xcvista/AT91SAM9260-SBC/ARM926SBC.sch

## EAGLE design ARM926SBC.sch (2017-03-12)

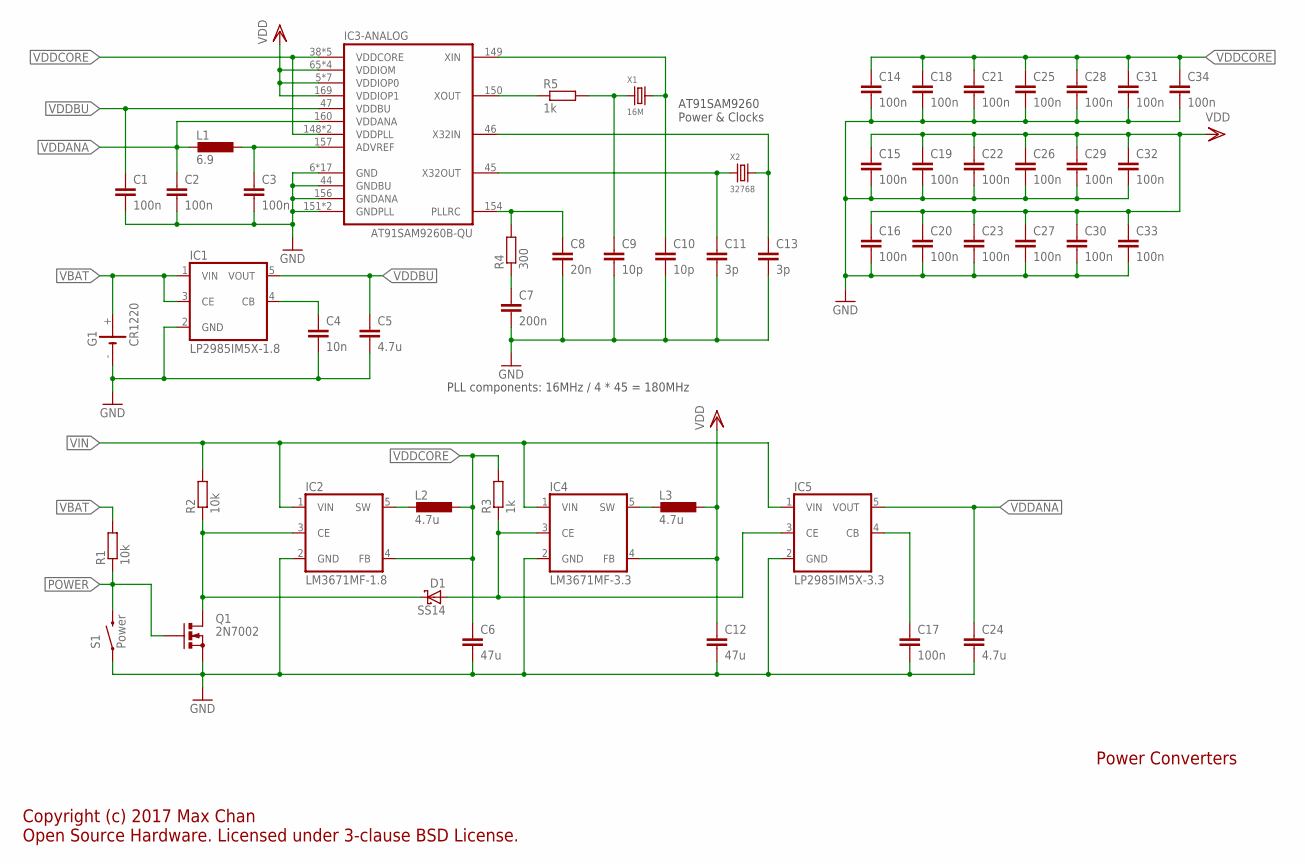
[picture p1: schematic ARM926SBC.sch, sheet 1]

Parts:
C1, C2, C3, C14, C15, C16, C17, C18, C19, C20, C21, C22, C23, C25, C26, C27, C28, C29, C30, C31, C32, C33, C34: 100n; C0603
C4: 10n; C0603
C5, C24: 4.7u; C0603
C6, C12: 47u; C1206
C7: 200n; C0603
C8: 20n; C0603
C9, C10: 10p; C0603
C11, C13: 3p; C0603
D1: SS14; DO214AC
G1: CR1220; CH291-1220LF
IC1: LP2985IM5X-1.8; SOT23-5L
IC2: LM3671MF-1.8; SOT23-5L
IC3: AT91SAM9260B-QU; PQFP208
IC4: LM3671MF-3.3; SOT23-5L
IC5: LP2985IM5X-3.3; SOT23-5L
L1: 6.9; R0603
L2, L3: 4.7u; L5650M
Q1: 2N7002; SOT23
R1, R2: 10k; R0603
R3, R5: 1k; R0603
R4: 300; R0603
S1: Power; TACTILE-SWITCH-1101NE
X1: 16M; CRYSTAL-3225
X2: 32768; CRYSTAL-3215

Connections:
ADVREF: C3.1, IC3.157 (ADVREF), L1.1
GND: C1.2, C2.2, C3.2, C4.2, C5.2, C6.2, C7.2, C8.2, C9.2, C10.2, C11.2, C12.2, C13.2, C14.2, C15.2, C16.2, C17.2, C18.2, C19.2, C20.2, C21.2, C22.2, C23.2, C24.2, C25.2, C26.2, C27.2, C28.2, C29.2, C30.2, C31.2, C32.2, C33.2, C34.2, G1.-, IC1.2 (GND), IC2.2 (GND), IC3.6 (GND), IC3.44 (GNDBU), IC3.151 (GNDPLL), IC3.156 (GNDANA), IC4.2 (GND), IC5.2 (GND), Q1.2 (S), S1.1
unnamed: C8.1, IC3.154 (PLLRC), R4.2
unnamed: C7.1, R4.1
unnamed: IC3.150 (XOUT), R5.1
unnamed: C9.1, R5.2, X1.1
unnamed: C10.1, IC3.149 (XIN), X1.3 (2)
unnamed: C11.1, IC3.45 (X32OUT), X2.1
unnamed: C13.1, IC3.46 (X32IN), X2.2
unnamed: C4.1, IC1.4 (CB)
unnamed: D1.A, IC4.3 (CE), IC5.3 (CE), R3.1
unnamed: IC2.5 (SW), L2.2
unnamed: IC4.5 (SW), L3.2
unnamed: C17.1, IC5.4 (CB)
unnamed: D1.C, IC2.3 (CE), Q1.3 (D), R2.1
POWER: Q1.1 (G), R1.1, S1.2
VBAT: G1.+, IC1.1 (VIN), IC1.3 (CE), R1.2
VDD: C12.1, C15.1, C16.1, C19.1, C20.1, C22.1, C23.1, C26.1, C27.1, C29.1, C30.1, C32.1, C33.1, IC3.5 (VDDIOP0), IC3.65 (VDDIOM), IC3.169 (VDDIOP1), IC4.4 (FB), L3.1
VDDANA: C2.1, C24.1, IC3.160 (VDDANA), IC5.5 (VOUT), L1.2
VDDBU: C1.1, C5.1, IC1.5 (VOUT), IC3.47 (VDDBU)
VDDCORE: C6.1, C14.1, C18.1, C21.1, C25.1, C28.1, C31.1, C34.1, IC2.4 (FB), IC3.38 (VDDCORE), IC3.148 (VDDPLL), L2.1, R3.2
VIN: IC2.1 (VIN), IC4.1 (VIN), IC5.1 (VIN), R2.2

Notes on the sheet:
AT91SAM9260 Power & Clocks
PLL components: 16MHz / 4 * 45 = 180MHz
Power Converters
Copyright (c) 2017 Max Chan Open Source Hardware. Licensed under 3-clause BSD License.

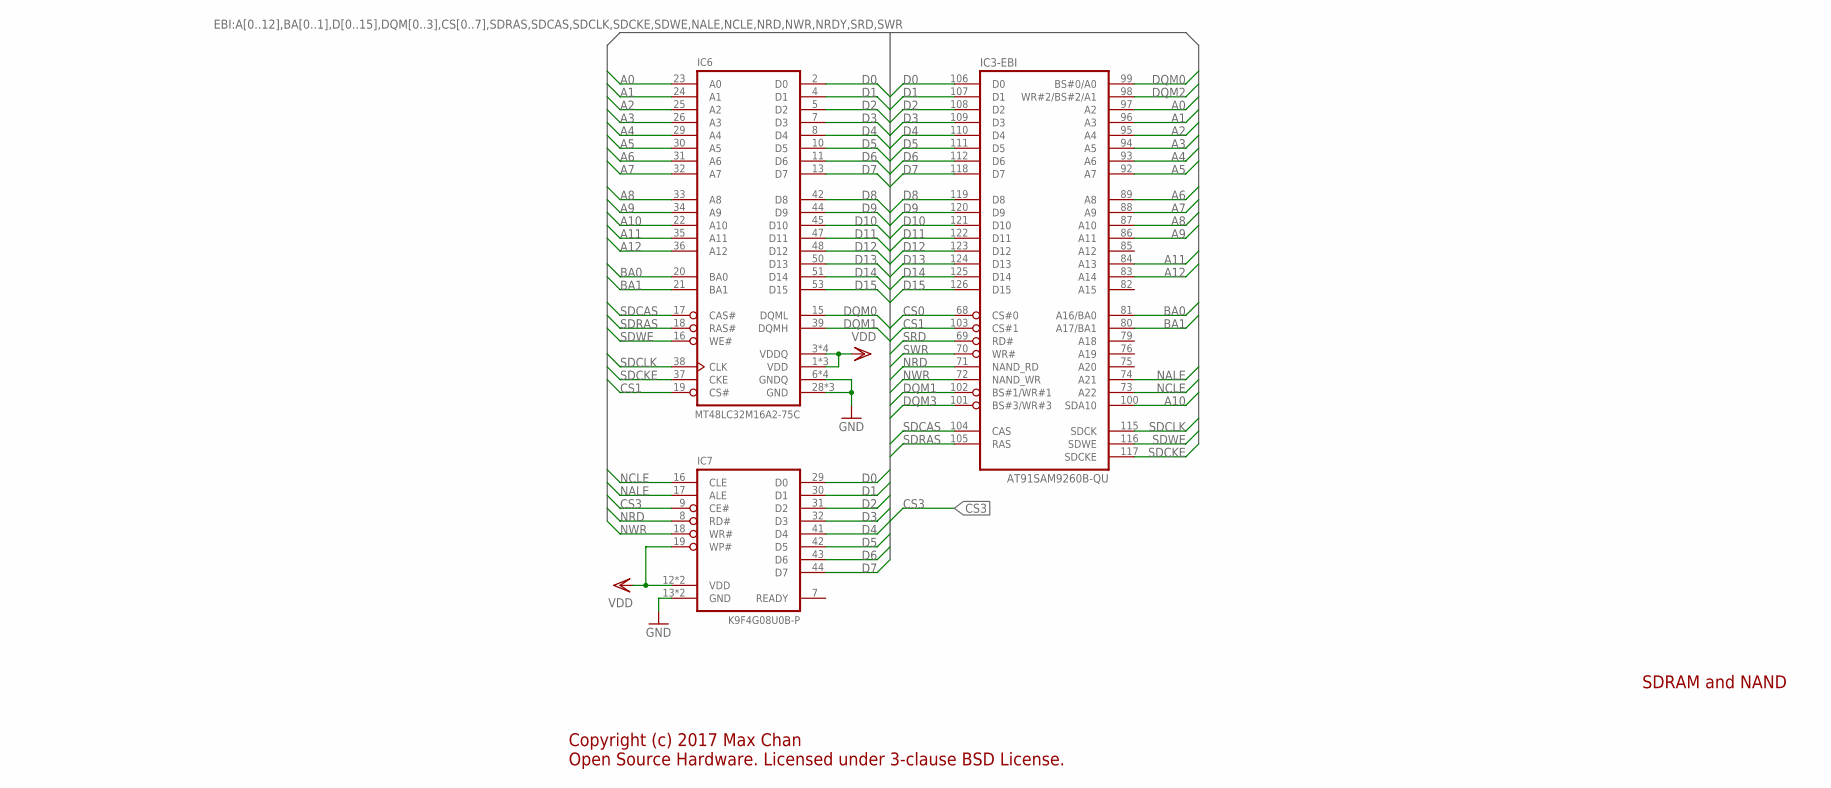
[picture p2: schematic ARM926SBC.sch, sheet 2]

Parts:
IC3: AT91SAM9260B-QU; PQFP208
IC6: MT48LC32M16A2-75C; TSOP54-400
IC7: K9F4G08U0B-P; TSOP48

Connections:
A0: IC3.97 (A2), IC6.23 (A0)
A1: IC3.96 (A3), IC6.24 (A1)
A2: IC3.95 (A4), IC6.25 (A2)
A3: IC3.94 (A5), IC6.26 (A3)
A4: IC3.93 (A6), IC6.29 (A4)
A5: IC3.92 (A7), IC6.30 (A5)
A6: IC3.89 (A8), IC6.31 (A6)
A7: IC3.88 (A9), IC6.32 (A7)
A8: IC3.87 (A10), IC6.33 (A8)
A9: IC3.86 (A11), IC6.34 (A9)
A10: IC3.100 (SDA10), IC6.22 (A10)
A11: IC3.84 (A13), IC6.35 (A11)
A12: IC3.83 (A14), IC6.36 (A12)
BA0: IC3.81 (A16/BA0), IC6.20 (BA0)
BA1: IC3.80 (A17/BA1), IC6.21 (BA1)
CS0: IC3.68 (CS#0)
CS1: IC3.103 (CS#1), IC6.19 (CS#)
CS3: IC7.9 (CE#)
D0: IC3.106 (D0), IC6.2 (D0), IC7.29 (D0)
D1: IC3.107 (D1), IC6.4 (D1), IC7.30 (D1)
D2: IC3.108 (D2), IC6.5 (D2), IC7.31 (D2)
D3: IC3.109 (D3), IC6.7 (D3), IC7.32 (D3)
D4: IC3.110 (D4), IC6.8 (D4), IC7.41 (D4)
D5: IC3.111 (D5), IC6.10 (D5), IC7.42 (D5)
D6: IC3.112 (D6), IC6.11 (D6), IC7.43 (D6)
D7: IC3.118 (D7), IC6.13 (D7), IC7.44 (D7)
D8: IC3.119 (D8), IC6.42 (D8)
D9: IC3.120 (D9), IC6.44 (D9)
D10: IC3.121 (D10), IC6.45 (D10)
D11: IC3.122 (D11), IC6.47 (D11)
D12: IC3.123 (D12), IC6.48 (D12)
D13: IC3.124 (D13), IC6.50 (D13)
D14: IC3.125 (D14), IC6.51 (D14)
D15: IC3.126 (D15), IC6.53 (D15)
DQM0: IC3.99 (BS#0/A0), IC6.15 (DQML)
DQM1: IC3.102 (BS#1/WR#1), IC6.39 (DQMH)
DQM2: IC3.98 (WR#2/BS#2/A1)
DQM3: IC3.101 (BS#3/WR#3)
GND: IC6.6 (GNDQ), IC6.28 (GND), IC7.13 (GND)
NALE: IC3.74 (A21), IC7.17 (ALE)
NCLE: IC3.73 (A22), IC7.16 (CLE)
NRD: IC3.71 (NAND_RD), IC7.8 (RD#)
NWR: IC3.72 (NAND_WR), IC7.18 (WR#)
SDCAS: IC3.104 (CAS), IC6.17 (CAS#)
SDCKE: IC3.117 (SDCKE), IC6.37 (CKE)
SDCLK: IC3.115 (SDCK), IC6.38 (CLK)
SDRAS: IC3.105 (RAS), IC6.18 (RAS#)
SDWE: IC3.116 (SDWE), IC6.16 (WE#)
SRD: IC3.69 (RD#)
SWR: IC3.70 (WR#)
VDD: IC6.1 (VDD), IC6.3 (VDDQ), IC7.12 (VDD), IC7.19 (WP#)

Notes on the sheet:
SDRAM and NAND
Copyright (c) 2017 Max Chan Open Source Hardware. Licensed under 3-clause BSD License.

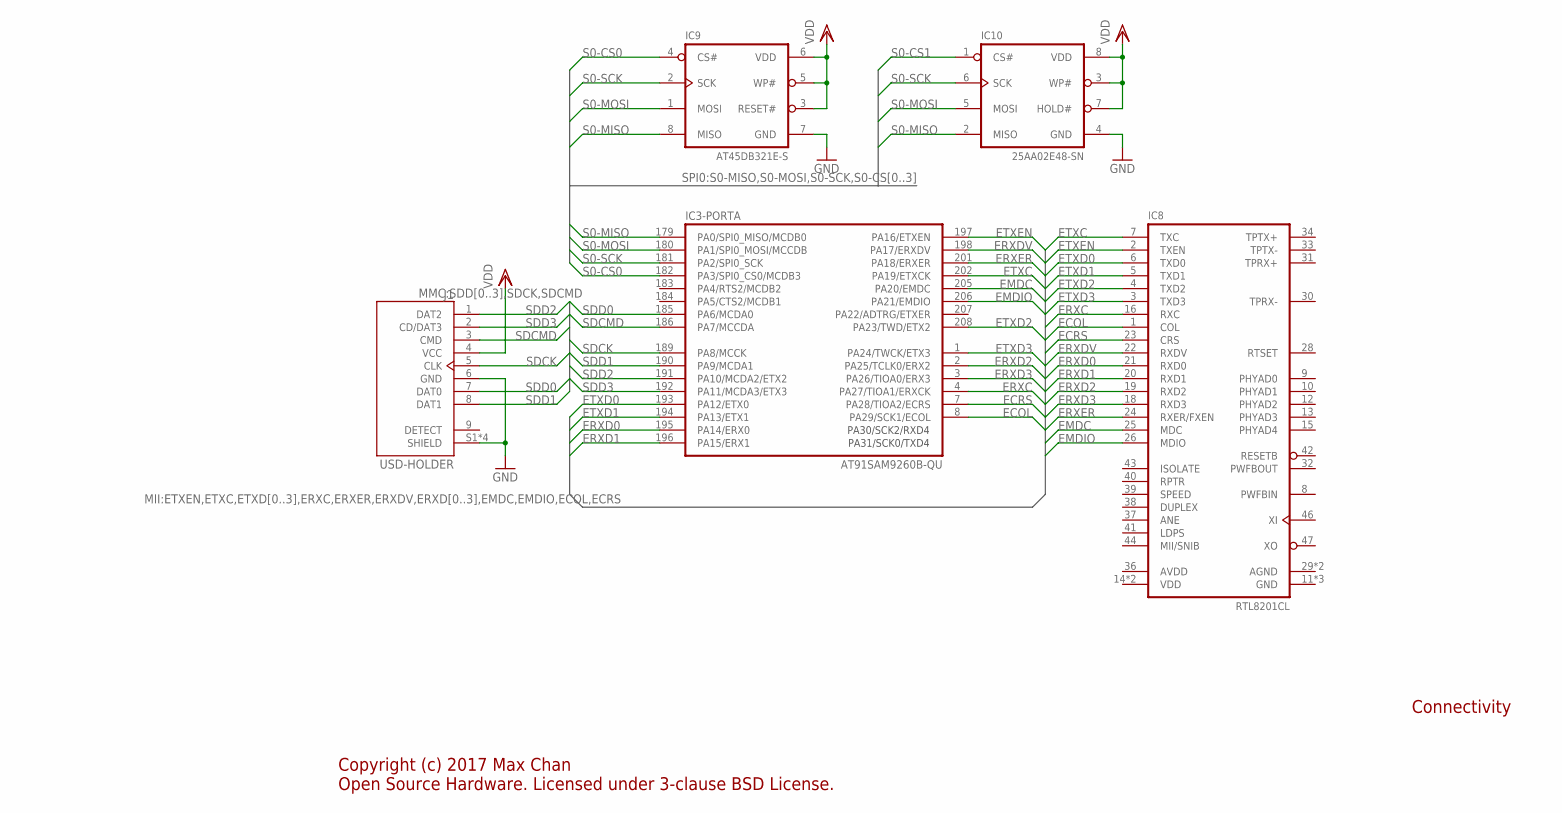
[picture p3: schematic ARM926SBC.sch, sheet 3]

Parts:
IC3: AT91SAM9260B-QU; PQFP208
IC8: RTL8201CL; SQFP-S-7X7-48
IC9: AT45DB321E-S; SO-08M
IC10: 25AA02E48-SN; SO-08
J1: USD-HOLDER

Connections:
ECOL: IC3.8 (PA29/SCK1/ECOL), IC8.1 (COL)
ECRS: IC3.7 (PA28/TIOA2/ECRS), IC8.23 (CRS)
EMDC: IC3.205 (PA20/EMDC), IC8.25 (MDC)
EMDIO: IC3.206 (PA21/EMDIO), IC8.26 (MDIO)
ERXC: IC3.4 (PA27/TIOA1/ERXCK), IC8.16 (RXC)
ERXD0: IC3.195 (PA14/ERX0), IC8.21 (RXD0)
ERXD1: IC3.196 (PA15/ERX1), IC8.20 (RXD1)
ERXD2: IC3.2 (PA25/TCLK0/ERX2), IC8.19 (RXD2)
ERXD3: IC3.3 (PA26/TIOA0/ERX3), IC8.18 (RXD3)
ERXDV: IC3.198 (PA17/ERXDV), IC8.22 (RXDV)
ERXER: IC3.201 (PA18/ERXER), IC8.24 (RXER/FXEN)
ETXC: IC3.202 (PA19/ETXCK), IC8.7 (TXC)
ETXD0: IC3.193 (PA12/ETX0), IC8.6 (TXD0)
ETXD1: IC3.194 (PA13/ETX1), IC8.5 (TXD1)
ETXD2: IC3.208 (PA23/TWD/ETX2), IC8.4 (TXD2)
ETXD3: IC3.1 (PA24/TWCK/ETX3), IC8.3 (TXD3)
ETXEN: IC3.197 (PA16/ETXEN), IC8.2 (TXEN)
GND: IC9.7 (GND), IC10.4 (GND), J1.6 (GND), J1.S1 (SHIELD)
S0-CS0: IC3.182 (PA3/SPI0_CS0/MCDB3), IC9.4 (CS#)
S0-CS1: IC10.1 (CS#)
S0-MISO: IC3.179 (PA0/SPI0_MISO/MCDB0), IC9.8 (MISO), IC10.2 (MISO)
S0-MOSI: IC3.180 (PA1/SPI0_MOSI/MCCDB), IC9.1 (MOSI), IC10.5 (MOSI)
S0-SCK: IC3.181 (PA2/SPI0_SCK), IC9.2 (SCK), IC10.6 (SCK)
SDCK: IC3.189 (PA8/MCCK), J1.5 (CLK)
SDCMD: IC3.186 (PA7/MCCDA), J1.3 (CMD)
SDD0: IC3.185 (PA6/MCDA0), J1.7 (DAT0)
SDD1: IC3.190 (PA9/MCDA1), J1.8 (DAT1)
SDD2: IC3.191 (PA10/MCDA2/ETX2), J1.1 (DAT2)
SDD3: IC3.192 (PA11/MCDA3/ETX3), J1.2 (CD/DAT3)
VDD: IC9.3 (RESET#), IC9.5 (WP#), IC9.6 (VDD), IC10.3 (WP#), IC10.7 (HOLD#), IC10.8 (VDD), J1.4 (VCC)

Notes on the sheet:
Connectivity
Copyright (c) 2017 Max Chan Open Source Hardware. Licensed under 3-clause BSD License.
