xcvista/AT91SAM9260-SBC/(commit log)

2017-03-12 Added STM32F030F4 and PMIC
2017-03-12 Completed: Power converters page
    [ARM926SBC.sch]
2017-03-12 Semi-finished: SDRAM and NAND
    [ARM926SBC.sch]
2017-03-12 Renamed parts
    [ARM926SBC.sch]
2017-03-12 Added some connectivity stuff.
    [ARM926SBC.sch]
